Mathod95/print/Boite_L_P1S_PLA_Matte_un_plateau.3mf

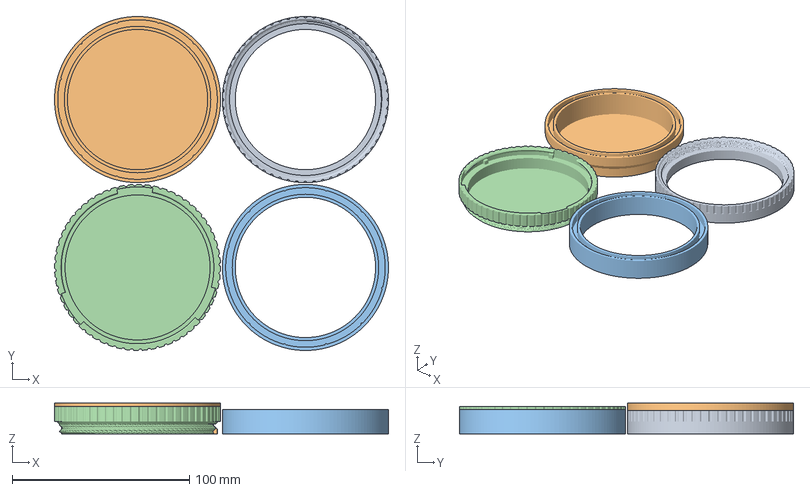
[picture p1: CAD file, 2026-11-09]
Boite_L_P1S_PLA_Matte_un_plateau.3mf
188.2 x 188.2 x 17.2 mm
Bague L (haut)
Fond L (une piece)
Manchon L (option double box)
Couvercle
